rumblesan/attiny-modulator/README.md

# Attiny85 Modulator

## Description

Based on the [JNTUB](https://github.com/joyfulnoisesynth/JNTUB) designed by Ben Reeves

## Contact

Drop me an email at guy@rumblesan.com

## License

BSD License.
