rumblesan/attiny-modulator/panel/panel.dxf

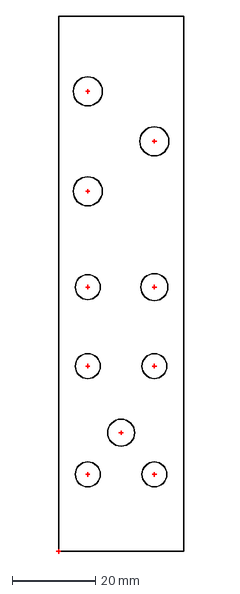
[picture p1: CAD file, 2023-06-19]
panel/panel.dxf
30.5 x 129.0 mm
