rumblesan/attiny-modulator/kicad/attiny-modulator.kicad_pcb

## KiCad design kicad/attiny-modulator.kicad_pcb (2024-07-06)

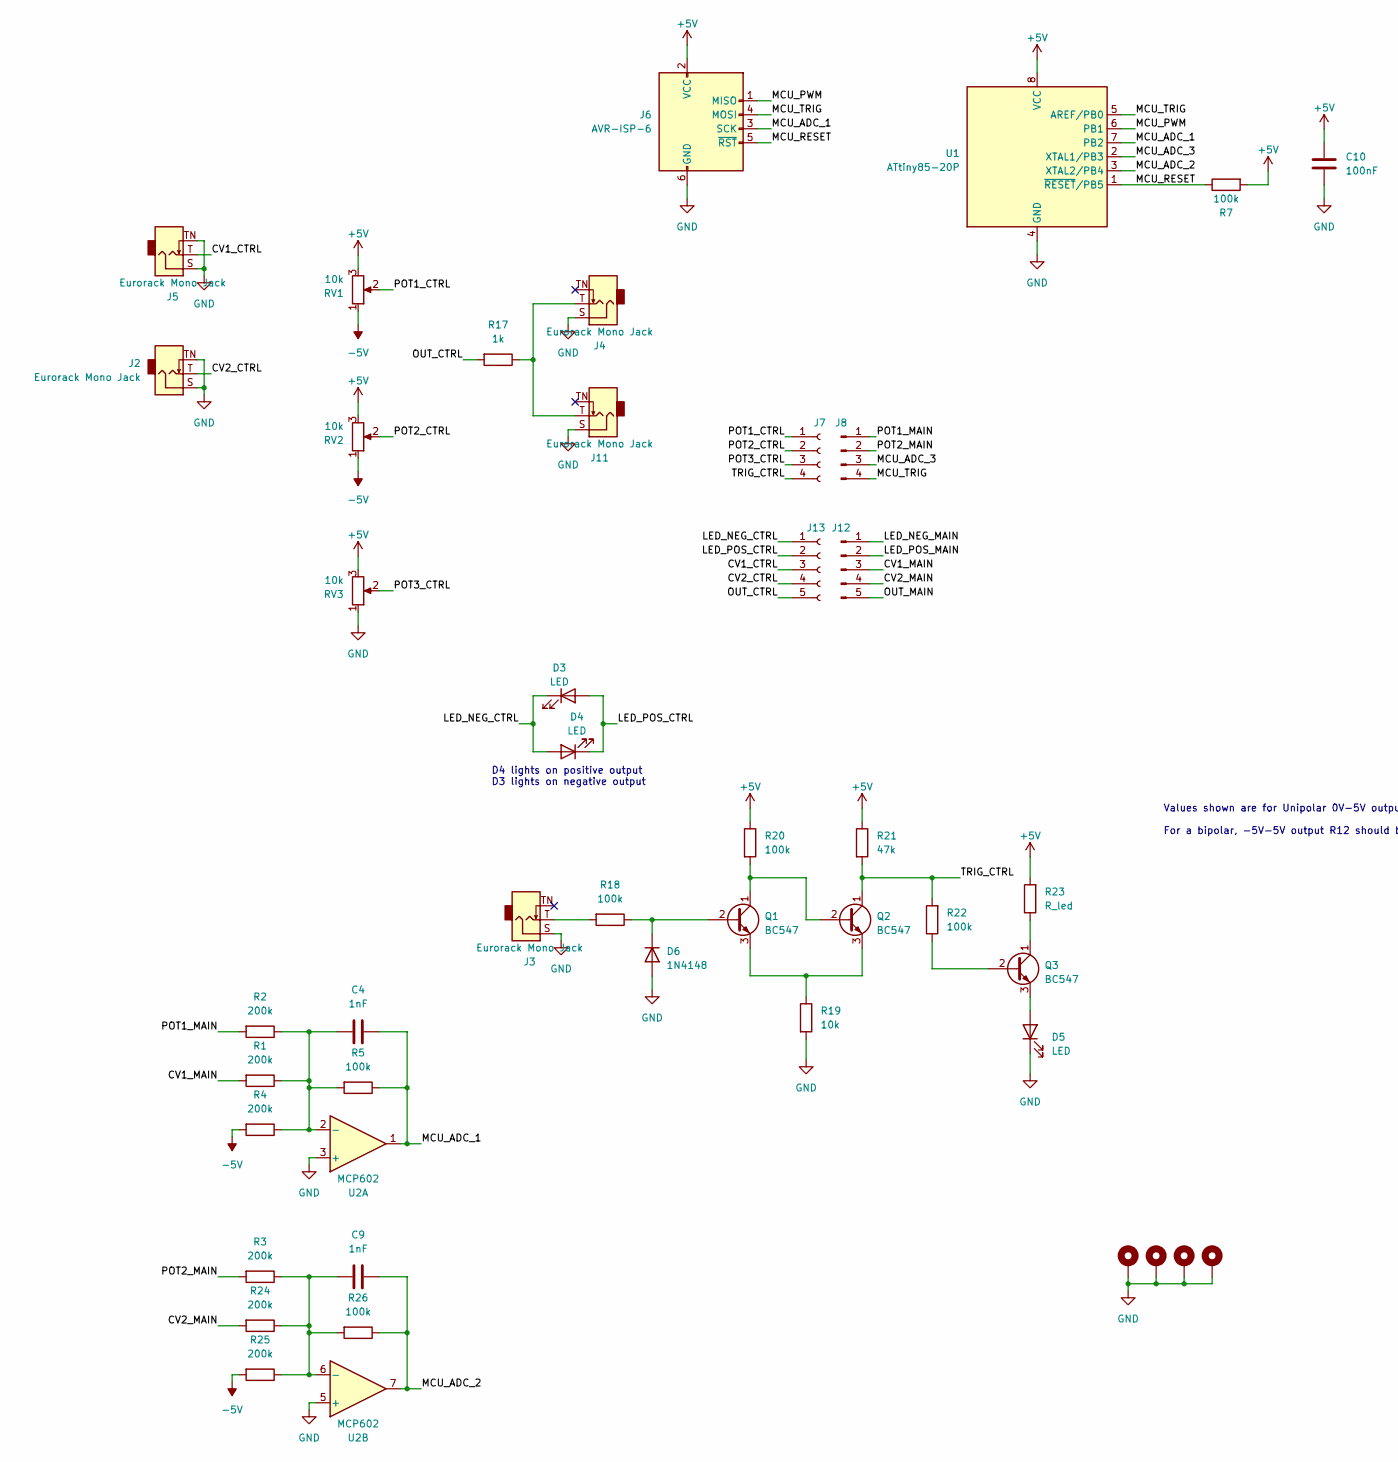
[picture p2: schematic attiny-modulator.kicad_sch, ATTiny Modulator, part in row 1, column 1]

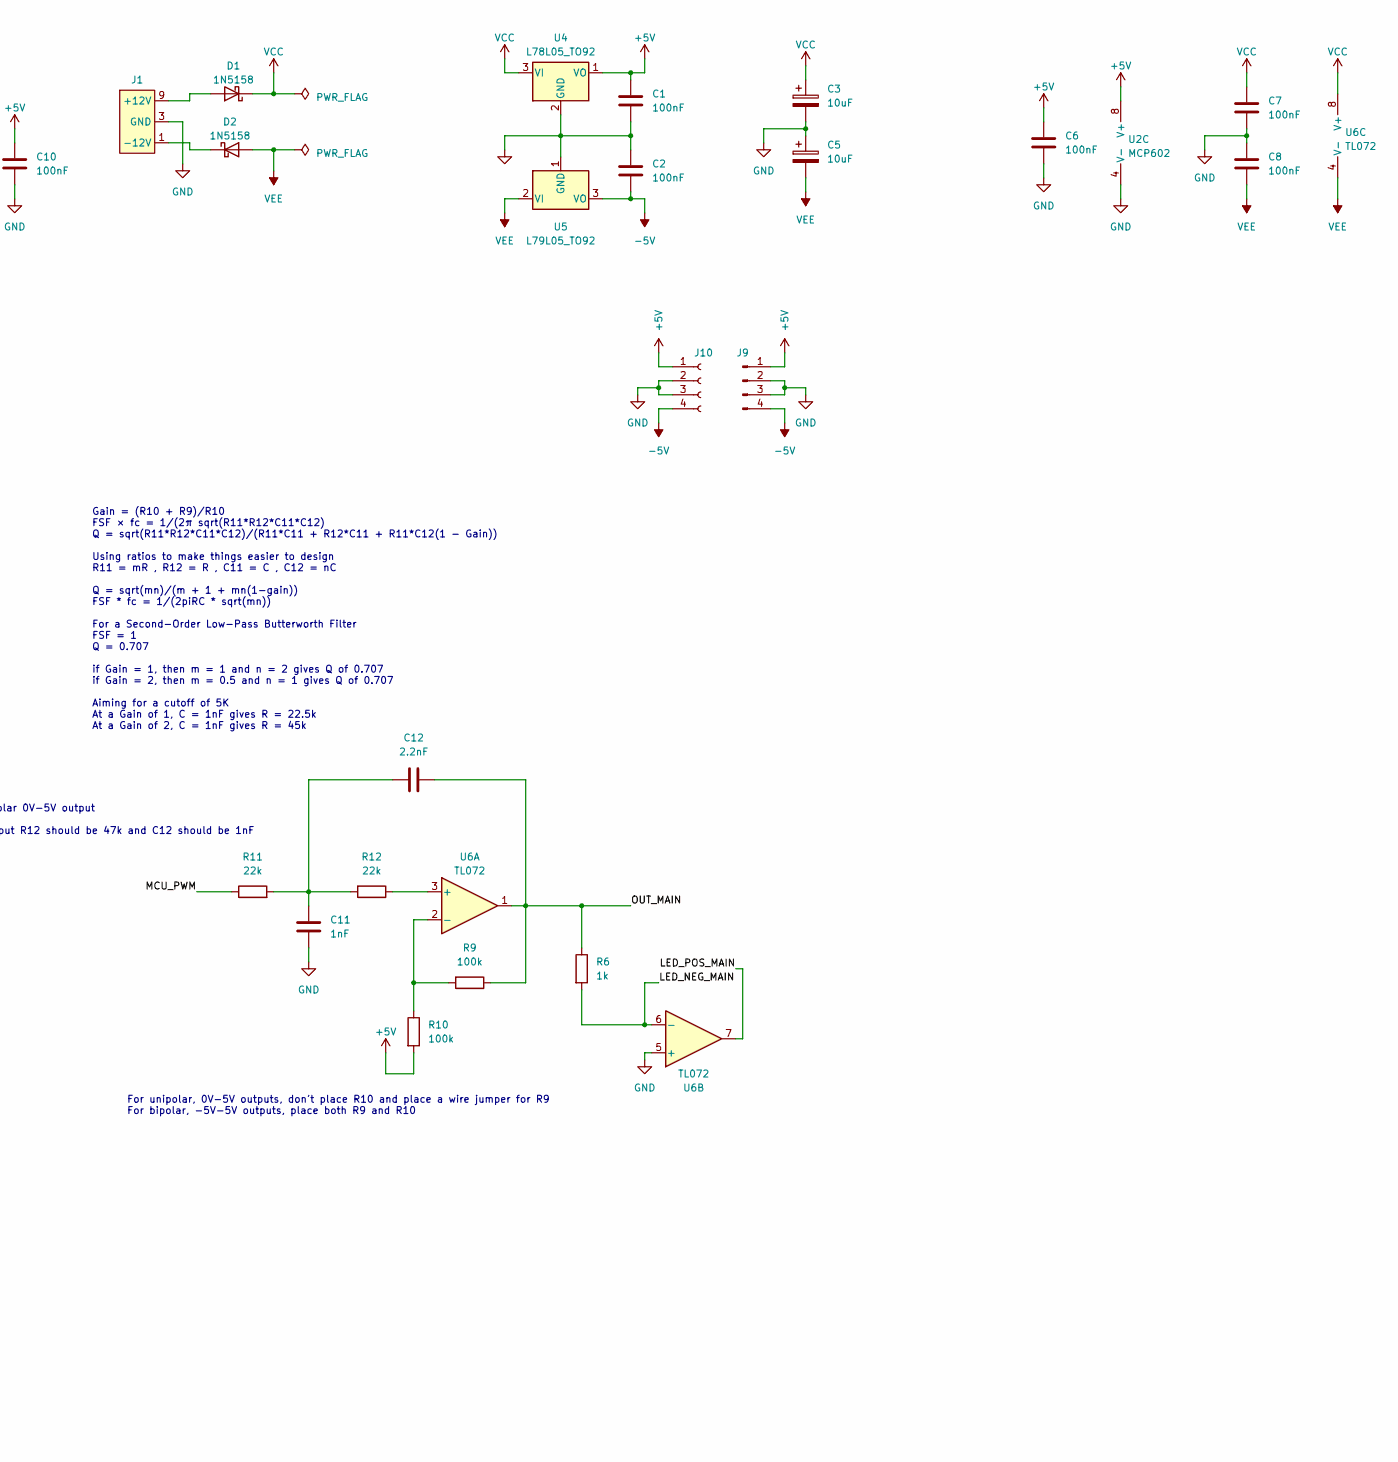
[picture p3: schematic attiny-modulator.kicad_sch, ATTiny Modulator, part in row 1, column 2]

Parts:
C1, C2, C6, C7, C8, C10: 100nF; C_Rect_L7.0mm_W2.5mm_P5.00mm; Tolerance 5%
C3, C5: 10uF; CP_Radial_D5.0mm_P2.00mm; Tolerance 20%; Voltage 50v
C4, C9, C11: 1nF; C_Rect_L7.0mm_W2.5mm_P5.00mm; Tolerance 5%
C12: 2.2nF; C_Rect_L7.0mm_W2.5mm_P5.00mm; Tolerance 5%
D1, D2: 1N5158; D_DO-41_SOD81_P10.16mm_Horizontal
D3, D4, D5: LED; LED_D1.8mm_W3.3mm_H2.4mm
D6: 1N4148; D_DO-35_SOD27_P7.62mm_Horizontal
H1, H2, H3, H4: MountingHole_Pad; MountingHole_3.2mm_M3_DIN965_Pad
J1: Eurorack Power Small; Eurorack_PowerHeader_2x05_P2.54mm_Shrouded
J2, J3, J4, J5, J11: Eurorack Mono Jack; Jack_3.5mm_QingPu_WQP-PJ398SM_Vertical; mpn WQP-WQP518MA
J6: AVR-ISP-6; PinHeader_2x03_P2.54mm_Vertical
J7, J10: Conn_01x04_Socket; PinSocket_1x04_P2.54mm_Vertical
J8, J9: Conn_01x04_Pin; PinHeader_1x04_P2.54mm_Vertical
J12: Conn_01x05_Pin; PinHeader_1x05_P2.54mm_Vertical
J13: Conn_01x05_Socket; PinSocket_1x05_P2.54mm_Vertical
Q1, Q2, Q3: BC547; TO-92_Inline_Wide
R1, R2, R3, R4, R24, R25: 200k; R_Axial_DIN0207_L6.3mm_D2.5mm_P10.16mm_Horizontal; Tolerance 1%
R5, R7, R9, R10, R18, R20, R22, R26: 100k; R_Axial_DIN0207_L6.3mm_D2.5mm_P10.16mm_Horizontal; Tolerance 1%
R6, R17: 1k; R_Axial_DIN0207_L6.3mm_D2.5mm_P10.16mm_Horizontal; Tolerance 1%
R11, R12: 22k; R_Axial_DIN0207_L6.3mm_D2.5mm_P10.16mm_Horizontal; Tolerance 1%
R19: 10k; R_Axial_DIN0207_L6.3mm_D2.5mm_P10.16mm_Horizontal; Tolerance 1%
R21: 47k; R_Axial_DIN0207_L6.3mm_D2.5mm_P10.16mm_Horizontal; Tolerance 1%
R23: R_led; R_Axial_DIN0207_L6.3mm_D2.5mm_P10.16mm_Horizontal; Tolerance 1%
RV1, RV2, RV3: 10k; Potentiometer_Alpha_RD901F-40-00D_Single_Vertical
U1: ATtiny85-20P; DIP-8_W7.62mm_Socket
U2: MCP602; DIP-8_W7.62mm_Socket
U4: L78L05_TO92; TO-92_Inline_Wide
U5: L79L05_TO92; TO-92_Inline_Wide
U6: TL072; DIP-8_W7.62mm_Socket

Connections:
+5V: C1.1, C6.1, C10.1, J6.2 (VCC), J9.1, J10.1, R7.2, R10.2, R20.1, R21.1, R23.2, RV1.3, RV2.3, RV3.3, U1.8 (VCC), U2.8 (V+), U4.1 (VO)
-5V: C2.2, J9.4, J10.4, R4.2, R25.2, RV1.1, RV2.1, U5.3 (VO)
/CV1_CTRL: J5.T, J13.3
/CV1_MAIN: J12.3, R1.2
/CV2_CTRL: J2.T, J13.4
/CV2_MAIN: J12.4, R24.2
/LED_NEG_CTRL: D3.1 (K), D4.2 (A), J13.1
/LED_NEG_MAIN: J12.1, R6.2, U6.6 (-)
/LED_POS_CTRL: D3.2 (A), D4.1 (K), J13.2
/LED_POS_MAIN: J12.2, U6.7
/MCU_ADC_1: C4.2, J6.3 (SCK), R5.1, U1.7 (PB2), U2.1
/MCU_ADC_2: C9.2, R26.1, U1.3 (XTAL2/PB4), U2.7
/MCU_ADC_3: J8.3, U1.2 (XTAL1/PB3)
/MCU_PWM: J6.1 (MISO), R11.1, U1.6 (PB1)
/MCU_RESET: J6.5 (~RST), R7.1, U1.1 (~RESET/PB5)
/MCU_TRIG: J6.4 (MOSI), J8.4, U1.5 (AREF/PB0)
/OUT_CTRL: J13.5, R17.2
/OUT_MAIN: C12.1, J12.5, R6.1, R9.1, U6.1
/POT1_CTRL: J7.1, RV1.2
/POT1_MAIN: J8.1, R2.2
/POT2_CTRL: J7.2, RV2.2
/POT2_MAIN: J8.2, R3.2
/POT3_CTRL: J7.3, RV3.2
/TRIG_CTRL: J7.4, Q2.1 (C), R21.2, R22.2
GND: C1.2, C2.1, C3.2, C5.1, C6.2, C7.2, C8.1, C10.2, C11.1, D5.1 (K), D6.2 (A), H1.1, H2.1, H3.1, H4.1, J1.3 (GND), J1.4 (GND), J1.5 (GND), J1.6 (GND), J1.7 (GND), J1.8 (GND), J2.S, J2.TN, J3.S, J4.S, J5.S, J5.TN, J6.6 (GND), J9.2, J9.3, J10.2, J10.3, J11.S, R19.2, RV3.1, U1.4 (GND), U2.3 (+), U2.4 (V-), U2.5 (+), U4.2 (GND), U5.1 (GND), U6.5 (+)
unnamed: C11.2, C12.2, R11.2, R12.2
unnamed: D1.2 (A), J1.9 (+12V), J1.10 (+12V)
unnamed: D2.1 (K), J1.1 (-12V), J1.2 (-12V)
unnamed: D5.2 (A), Q3.3 (E)
unnamed: D6.1 (K), Q1.2 (B), R18.1
unnamed: J3.T, R18.2
unnamed: J4.T, J11.T, R17.1
unnamed: Q1.1 (C), Q2.2 (B), R20.2
unnamed: Q1.3 (E), Q2.3 (E), R19.1
unnamed: Q3.2 (B), R22.1
unnamed: Q3.1 (C), R23.1
unnamed: C4.1, R1.1, R2.1, R4.1, R5.2, U2.2 (-)
unnamed: C9.1, R3.1, R24.1, R25.1, R26.2, U2.6 (-)
unnamed: R12.1, U6.3 (+)
unnamed: R9.2, R10.1, U6.2 (-)
VCC: C3.1, C7.1, D1.1 (K), U4.3 (VI), U6.8 (V+)
VEE: C5.2, C8.2, D2.2 (A), U5.2 (VI), U6.4 (V-)

Notes on the sheet:
D4 lights on positive output D3 lights on negative output
For unipolar, 0V-5V outputs, don't place R10 and place a wire jumper for R9 For bipolar, -5V-5V outputs, place both R9 and R10
Gain = (R10 + R9)/R10 FSF × fc = 1/(2π sqrt(R11*R12*C11*C12) Q = sqrt(R11*R12*C11*C12)/(R11*C11 + R12*C11 + R11*C12(1 − Gain)) Using ratios to make things easier to design R11 = mR , R12 = R , C11 = C , C12 = nC Q = sqrt(mn)/(m + 1 + mn(1-gain)) FSF * fc = 1/(2piRC * sqrt(mn)) For a Second-Order Lo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
Values shown are for Unipolar 0V-5V output For a bipolar, -5V-5V output R12 should be 47k and C12 should be 1nF

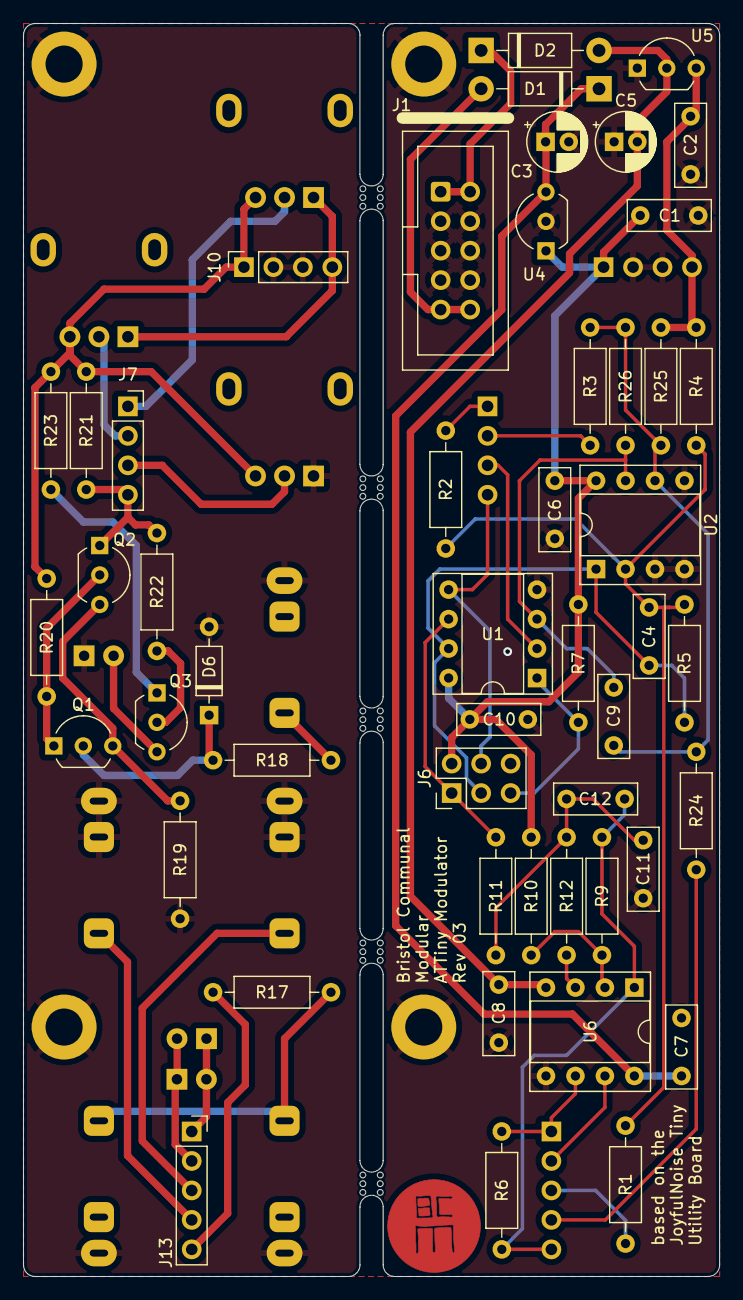
[picture p4: board attiny-modulator.kicad_pcb from above]

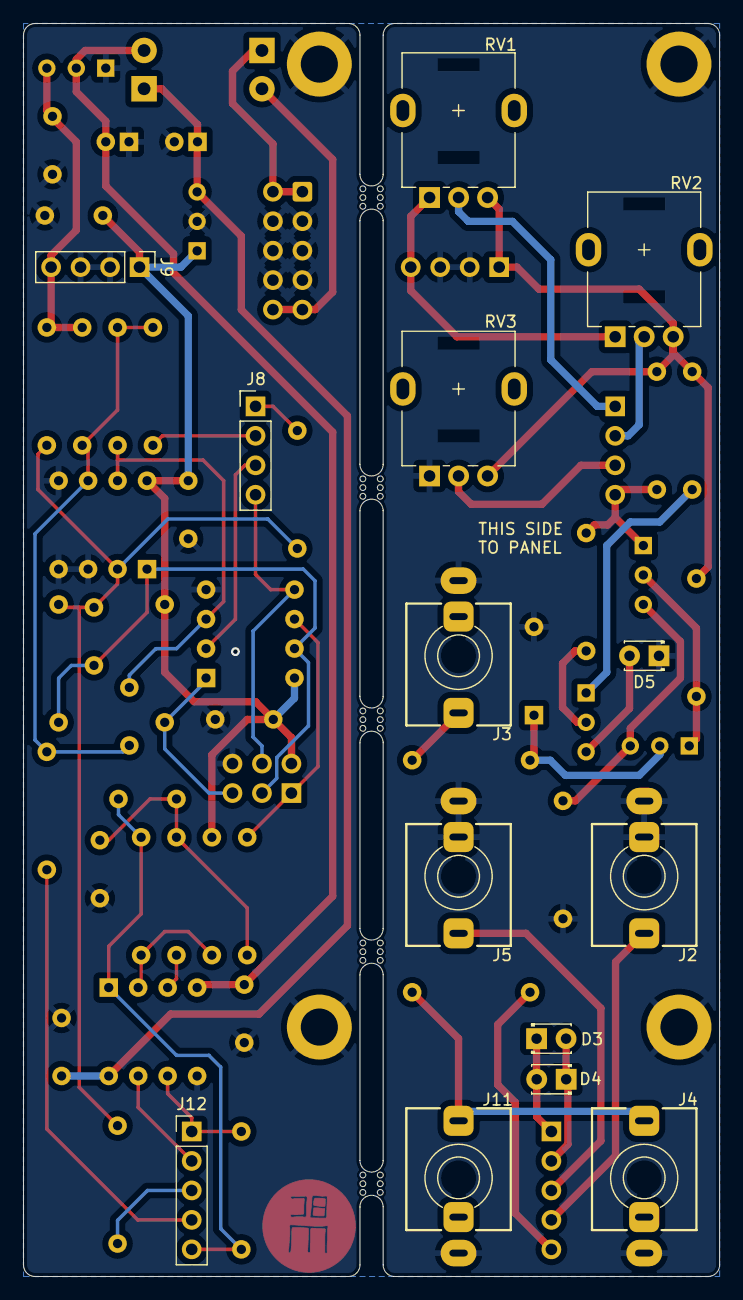
[picture p5: board attiny-modulator.kicad_pcb from below]

Board: 2 copper layers, 60.0 x 108.0 mm, 72 parts (14 on the bottom side), 42 nets.

Other parts of the board:
mouse-bite-2mm-slot, mouse-bite-2mm-slot#2, mouse-bite-2mm-slot#3, mouse-bite-2mm-slot#4, mouse-bite-2mm-slot#5: VAL**; mouse-bite-2mm-slot
