rumblesan/attiny-modulator/firmware/envelope/include/envelope_curves.h

#include <avr/pgmspace.h>

const uint8_t ENV_LINEAR[257] PROGMEM = {
  0, // 0
  1, // 1
  2, // 2
  3, // 3
  4, // 4
  5, // 5
  6, // 6
  7, // 7
  8, // 8
  9, // 9
  10, // 10
  11, // 11
  12, // 12
  13, // 13
  14, // 14
  15, // 15
  16, // 16
  17, // 17
  18, // 18
  19, // 19
  20, // 20
  21, // 21
  22, // 22
  23, // 23
  24, // 24
  25, // 25
  26, // 26
  27, // 27
  28, // 28
  29, // 29
  30, // 30
  31, // 31
  32, // 32
  33, // 33
  34, // 34
  35, // 35
  36, // 36
  37, // 37
  38, // 38
  39, // 39
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
};


const uint8_t ENV_QUADRATIC[257] PROGMEM = {
  0, // 0
  0, // 1
  0, // 2
  0, // 3
  0, // 4
  0, // 5
  0, // 6
  0, // 7
  0, // 8
  0, // 9
  0, // 10
  0, // 11
  1, // 12
  1, // 13
  1, // 14
  1, // 15
  1, // 16
  1, // 17
  1, // 18
  1, // 19
  2, // 20
  2, // 21
  2, // 22
  2, // 23
  2, // 24
  2, // 25
  3, // 26
  3, // 27
  3, // 28
  3, // 29
  4, // 30
  4, // 31
  4, // 32
  4, // 33
  5, // 34
  5, // 35
  5, // 36
  5, // 37
  6, // 38
  6, // 39
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
};


const uint8_t ENV_INV_QUADRATIC[257] PROGMEM = {
  0, // 0
  2, // 1
  4, // 2
  6, // 3
  8, // 4
  10, // 5
  12, // 6
  14, // 7
  16, // 8
  18, // 9
  20, // 10
  22, // 11
  23, // 12
  25, // 13
  27, // 14
  29, // 15
  31, // 16
  33, // 17
  35, // 18
  37, // 19
  38, // 20
  40, // 21
  42, // 22
  44, // 23
  46, // 24
  48, // 25
  49, // 26
  51, // 27
  53, // 28
  55, // 29
  56, // 30
  58, // 31
  60, // 32
  62, // 33
  63, // 34
  65, // 35
  67, // 36
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
  216, // 18
  218, // 19
  220, // 20
  222, // 21
  223, // 22
  225, // 23
  226, // 24
  227, // 25
  228, // 26
  230, // 27
  231, // 28
  231, // 29
  232, // 30
  233, // 31
  234, // 32
  235, // 33
  235, // 34
  236, // 35
  237, // 36
  237, // 37
  238, // 38
  238, // 39
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
};
