rumblesan/attiny-modulator/firmware/lfo/include/wavetables.h

#include <avr/pgmspace.h>
#include <stdint.h>

const uint8_t WT_SINE[256] PROGMEM = {
  128, // 0
  131, // 1
  134, // 2
  137, // 3
  140, // 4
  144, // 5
  147, // 6
  150, // 7
  153, // 8
  156, // 9
  159, // 10
  162, // 11
  165, // 12
  168, // 13
  171, // 14
  174, // 15
  177, // 16
  179, // 17
  182, // 18
  185, // 19
  188, // 20
  191, // 21
  193, // 22
  196, // 23
  199, // 24
  201, // 25
  204, // 26
  206, // 27
  209, // 28
  211, // 29
  213, // 30
  216, // 31
  218, // 32
  220, // 33
  222, // 34
  224, // 35
  226, // 36
  228, // 37
  230, // 38
  232, // 39
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
};

const uint8_t WT_SAW[256] PROGMEM = {
  0, // 0
  1, // 1
  2, // 2
  3, // 3
  4, // 4
  5, // 5
  6, // 6
  7, // 7
  8, // 8
  9, // 9
  10, // 10
  11, // 11
  12, // 12
  13, // 13
  14, // 14
  15, // 15
  16, // 16
  17, // 17
  18, // 18
  19, // 19
  20, // 20
  21, // 21
  22, // 22
  23, // 23
  24, // 24
  25, // 25
  26, // 26
  27, // 27
  28, // 28
  29, // 29
  30, // 30
  31, // 31
  32, // 32
  33, // 33
  34, // 34
  35, // 35
  36, // 36
  37, // 37
  38, // 38
  39, // 39
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
};

const uint8_t WT_SQUARE[256] PROGMEM = {
  0, // 0
  0, // 1
  0, // 2
  0, // 3
  0, // 4
  0, // 5
  0, // 6
  0, // 7
  0, // 8
  0, // 9
  0, // 10
  0, // 11
  0, // 12
  0, // 13
  0, // 14
  0, // 15
  0, // 16
  0, // 17
  0, // 18
  0, // 19
  0, // 20
  0, // 21
  0, // 22
  0, // 23
  0, // 24
  0, // 25
  0, // 26
  0, // 27
  0, // 28
  0, // 29
  0, // 30
  0, // 31
  0, // 32
  0, // 33
  0, // 34
  0, // 35
  0, // 36
  0, // 37
  0, // 38
  0, // 39
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
};

const uint8_t WT_RANDOM[256] PROGMEM = {
  141, // 0
  101, // 1
  214, // 2
  240, // 3
  150, // 4
  26, // 5
  201, // 6
  71, // 7
  85, // 8
  7, // 9
  218, // 10
  95, // 11
  131, // 12
  50, // 13
  219, // 14
  137, // 15
  160, // 16
  182, // 17
  28, // 18
  178, // 19
  252, // 20
  53, // 21
  219, // 22
  244, // 23
  219, // 24
  93, // 25
  209, // 26
  135, // 27
  244, // 28
  222, // 29
  194, // 30
  72, // 31
  253, // 32
  60, // 33
  3, // 34
  68, // 35
  157, // 36
  239, // 37
  192, // 38
  158, // 39
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
};
