rumblesan/attiny-modulator/(commit log)

2023-05-21 Creating kicad project
    [attiny-modulator.kicad_pcb, attiny-modulator.kicad_sch]
2023-06-19 Updating schematic, layout and front panel
    [attiny-modulator-frontpanel.kicad_pcb, attiny-modulator.kicad_pcb, attiny-modulator.kicad_sch, panel.dxf]
2023-07-06 Fixing bugs with circuit
    [attiny-modulator-frontpanel.kicad_pcb, attiny-modulator.kicad_pcb, attiny-modulator.kicad_sch]
2023-12-24 Tweaks for rev02
    [attiny-modulator.kicad_pcb, attiny-modulator.kicad_sch]
2023-12-24 Adding rev02 gerbers
    [attiny-modulator-B_Cu.gbl, attiny-modulator-B_Mask.gbs, attiny-modulator-B_Silkscreen.gbo, attiny-modulator-Edge_Cuts.gm1, attiny-modulator-F_Cu.gtl, attiny-modulator-F_Mask.gts, attiny-modulator-F_Silkscreen.gto, attiny-modulator-NPTH.drl]
2024-07-06 Refreshing board layout
    [attiny-modulator.kicad_pcb, attiny-modulator.kicad_sch]
