rumblesan/attiny-modulator/(notices)

Notices in the files:
kicad/attiny-modulator-frontpanel.kicad_pcb:
creativecommons.org/licenses/by/4.0
License: CC BY 4.0
